IPTeCA/Glider-Control_Cluster-Comunication/assets/models/TCS_Best_Machine.obj

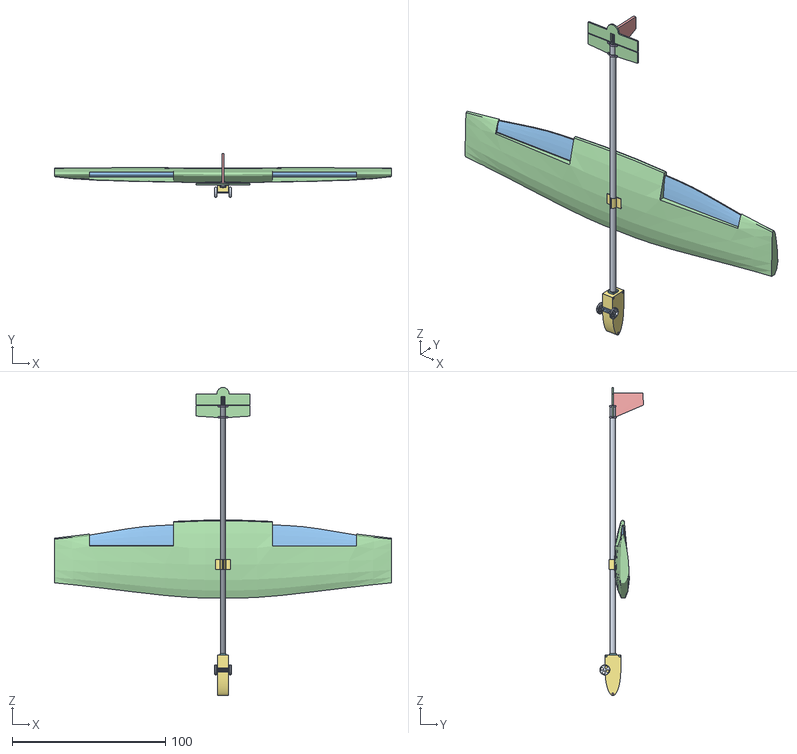
[picture p4: CAD file, 2026-09-27]
assets/models/TCS_Best_Machine.obj
220.2 x 28.4 x 201.5
obj1
obj2
obj3
obj4
obj5
obj6
obj7
obj8
obj9
obj10
obj11
obj12
obj13
obj14
obj15
obj16
obj17
obj18
obj19
obj20
obj21
obj22
obj23
